IsoGrid/IsoSwitch/HW/HW.kicad_pcb

## KiCad design HW/HW.kicad_pcb (2018-03-01)

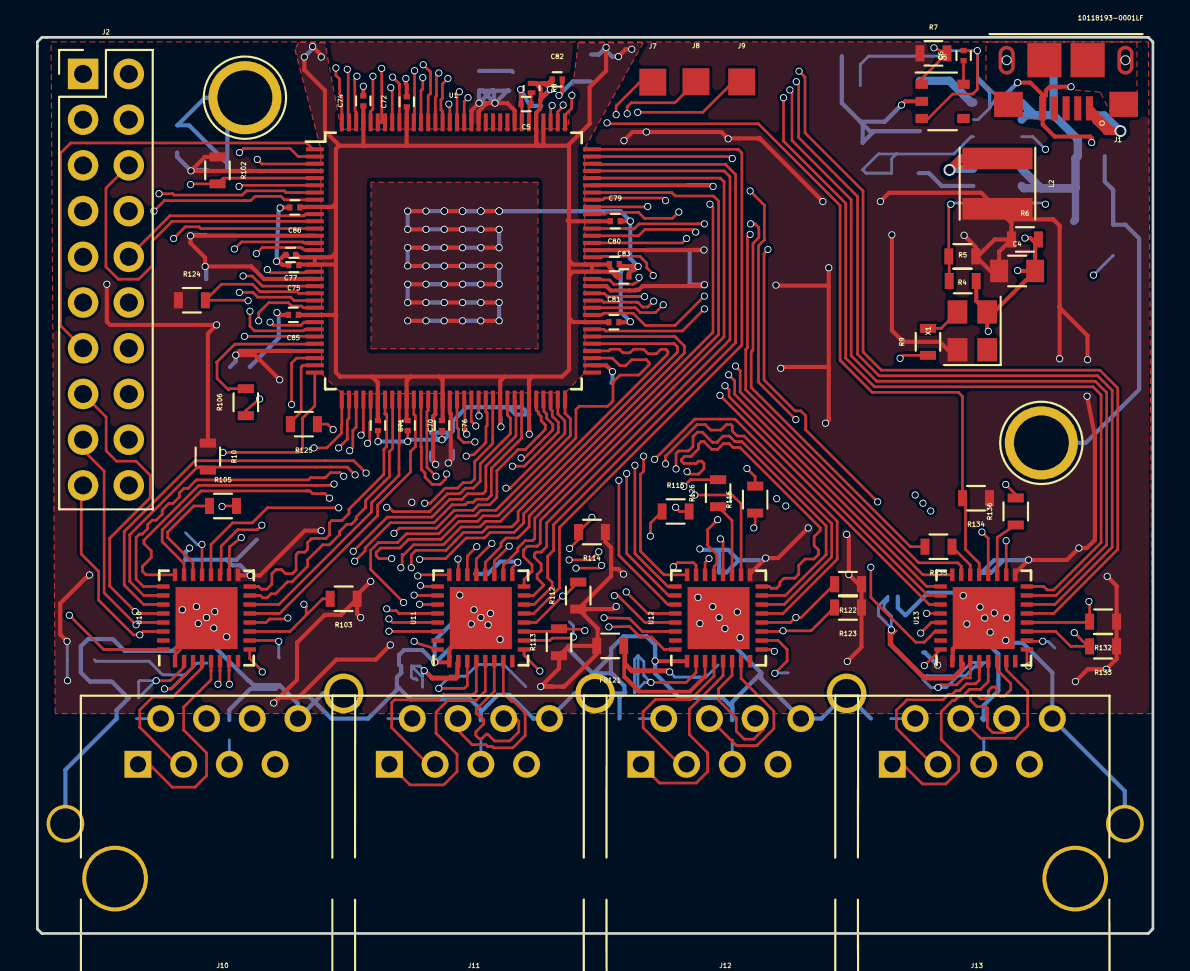
[picture p4: board HW.kicad_pcb from above]

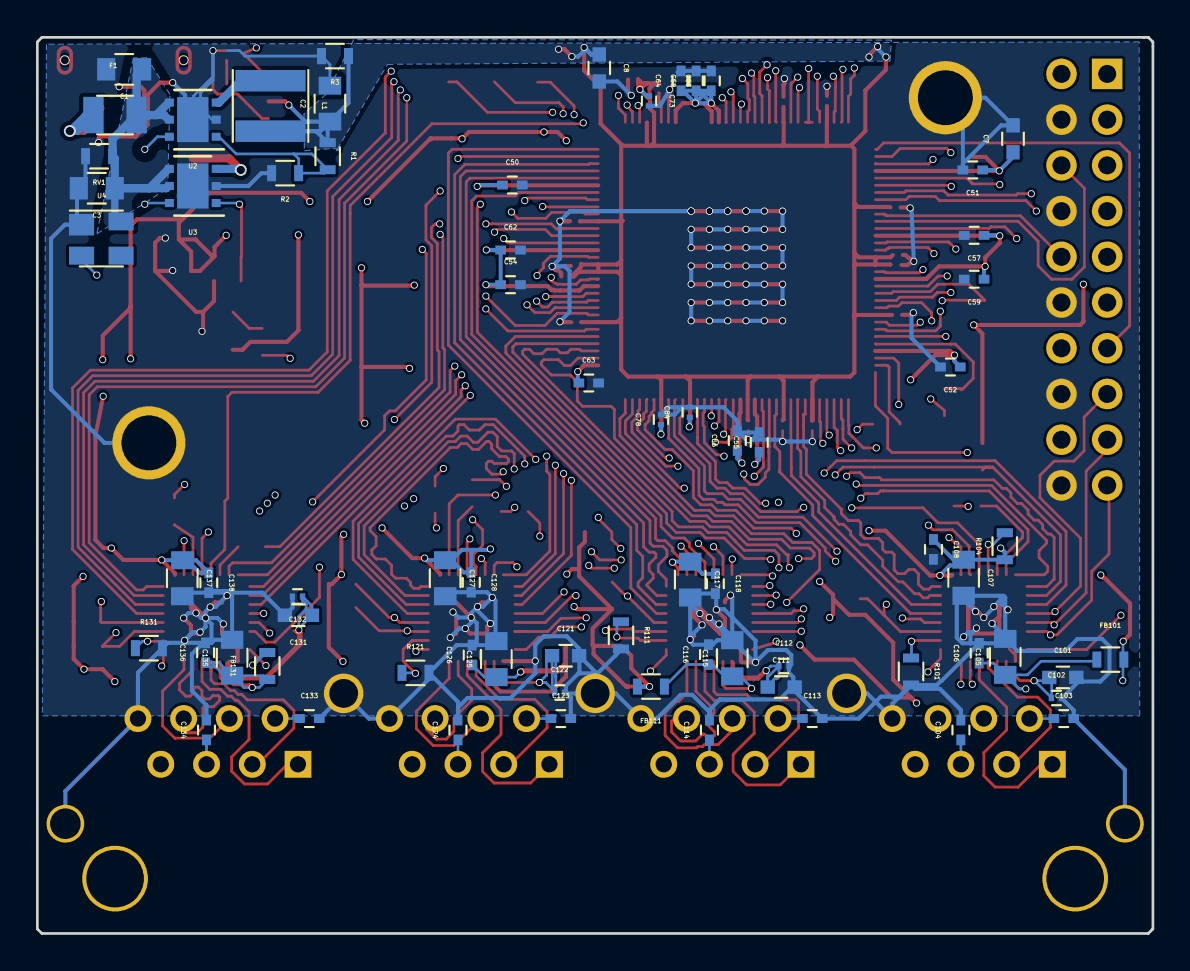
[picture p5: board HW.kicad_pcb from below]

Board: 4 copper layers, 62.0 x 49.8 mm, 133 parts (70 on the bottom side), 147 nets.

Parts:
C1, C3: 4.7uF; C_0805
C2, C4, C105, C107, C115, C117, C125, C127, C135, C137: 22uF; C_0805
C5, C6, C70, C71, C72, C73, C74, C75, C76, C77, C78, C79, C80, C81, C82, C83, C84, C85, C86, C102, C112, C122, C132: 100nF; C_0201
C7, C8, C101, C111, C121, C131: 2.2uF; C_0603
C50, C51, C52, C53, C54, C55, C56, C57, C58, C59, C62, C63, C64, C103, C104, C106, C108, C113, C114, C116, C118, C123, C124, C126, C128, C133, C134, C136, C138: 100nF; C_0402
F1: 1206L110; Fuse_SMD1206_Reflow
FB101, FB111, FB121, FB131: FERRITE BEAD; L_0603
J1: 10118193-0001LF; FCI_10118193-0001LF
J2: 2x10 Vertical Pin; Pin_Header_Straight_2x10_Pitch2.54mm
J7: NWAY_TP; Measurement_Point_Square-SMD-Pad_Small
J8: CRS_TP; Measurement_Point_Square-SMD-Pad_Small
J9: COL_TP; Measurement_Point_Square-SMD-Pad_Small
J10, J11, J12, J13: RJ45_0; RJ45_LINK-PP
L1, L2: 3.3uH; L_Taiyo-Yuden_NR-40xx
Mount2, Mount3: 1pin
R1: 4.7K; R_0603
R2, R4: 18K; R_0603
R3, R103, R104, R113, R114, R123, R124, R133, R134: 1K; R_0603
R5: 5.6K; R_0603
R6: 2.2K; R_0603
R7: 47K; R_0603
R8: 4.7R; R_0201
R9, R105, R106, R115, R116, R125, R126, R135, R136: 33R; R_0603
R10: 3.3K; R_0603
R101, R111, R121, R131: 6.49K; R_0603
R102, R112, R122, R132: 10K; R_0603
RV1: V5.5MLA0603H; R_0603
U1: XL216-512-TQ128_CHIP_VIEW; TQFP-128_14x14mm_Pitch0.4mm
U2, U3: ST1S06; DFN6D_3x3mm
U4: APX811-46UG-7; SOT-143
U5: NCP303LSN10T; TSOP-5_1.65x3.05mm_Pitch0.95mm
U10, U11, U12, U13: KSZ8081MNX; QFN-32-1EP_5x5mm_Pitch0.5mm
X1: DSC6001CI2A-025.0000; Oscillator_SMD_Abracon_ASE-4pin_3.2x2.5mm

Connections:
25M: R9.1, U1.124, U10.9, U11.9, U12.9, U13.9
+1V0: C2.1, C8.1, C70.1, C71.1, C72.1, C73.1, C74.1, C75.1, C76.1, C77.1, C78.1, C79.1, C80.1, C81.1, C82.1, C83.1, C84.1, C85.1, C86.1, L1.2, R1.1, R3.1, R8.1, U1.9, U1.16, U1.17, U1.24, U1.38, U1.42, U1.47, U1.55, U1.59, U1.72, U1.79, U1.80, U1.86, U1.100, U1.101, U1.119, U1.125, U5.2
+3V3: C4.1, C7.1, C50.1, C51.1, C52.1, C53.1, C54.1, C55.1, C56.1, C57.1, C58.1, C59.1, C62.1, C63.1, C64.1, C107.1, C108.1, C117.1, C118.1, C127.1, C128.1, C137.1, C138.1, FB101.2, FB111.2, FB121.2, FB131.2, L2.2, R4.1, R6.1, R7.1, R10.1, R102.1, R103.1, R104.1, R112.1, R113.1, R114.1, R122.1, R123.1, R124.1, R132.1, R133.1, R134.1, U1.4, U1.13, U1.19, U1.29, U1.46, U1.48, U1.66, U1.77, U1.82, U1.91, U1.104, U1.109, U1.110, U10.17, U11.17, U12.17, U13.17, X1.4
+5V: C1.1, C3.1, F1.2, RV1.1, U2.4, U2.5, U3.4, U3.5, U4.4
/PG_5V: U2.6, U3.6, U4.2
/Tile0/EthernetPort0/INT: R104.2, U1.6, U10.21
/Tile0/EthernetPort0/MDC: R102.2, U1.5, U10.12
/Tile0/EthernetPort0/MDIO: R103.2, U1.3, U10.11
/Tile0/EthernetPort0/RST_N: U1.2, U10.32
/Tile0/EthernetPort0/RXC: R106.2, U1.28
/Tile0/EthernetPort0/RXD0: U1.39, U10.16
/Tile0/EthernetPort0/RXD1: U1.40, U10.15
/Tile0/EthernetPort0/RXD2: U1.41, U10.14
/Tile0/EthernetPort0/RXD3: U1.43, U10.13
/Tile0/EthernetPort0/RXDV: U1.27, U10.18
/Tile0/EthernetPort0/RXERR: U1.56, U10.20
/Tile0/EthernetPort0/TXC: R105.2, U1.32
/Tile0/EthernetPort0/TXD0: U1.34, U10.24
/Tile0/EthernetPort0/TXD1: U1.35, U10.25
/Tile0/EthernetPort0/TXD2: R10.2, U1.36, U10.26
/Tile0/EthernetPort0/TXD3: U1.37, U10.27
/Tile0/EthernetPort0/TXEN: U1.33, U10.23
/Tile0/EthernetPort1/COL: J9.1, U1.97, U11.28
/Tile0/EthernetPort1/CRS: J8.1, U1.98, U11.29
/Tile0/EthernetPort1/INT: R114.2, U1.63, U11.21
/Tile0/EthernetPort1/MDC: R112.2, U1.87, U11.12
/Tile0/EthernetPort1/MDIO: R113.2, U1.88, U11.11
/Tile0/EthernetPort1/NWAYEN: J7.1, U1.99, U11.30
/Tile0/EthernetPort1/RST_N: U1.64, U11.32
/Tile0/EthernetPort1/RXC: R116.2, U1.89
/Tile0/EthernetPort1/RXD0: U1.92, U11.16
/Tile0/EthernetPort1/RXD1: U1.93, U11.15
/Tile0/EthernetPort1/RXD2: U1.94, U11.14
/Tile0/EthernetPort1/RXD3: U1.96, U11.13
/Tile0/EthernetPort1/RXDV: U1.90, U11.18
/Tile0/EthernetPort1/RXERR: U1.95, U11.20
/Tile0/EthernetPort1/TXC: R115.2, U1.62
/Tile0/EthernetPort1/TXD0: U1.67, U11.24
/Tile0/EthernetPort1/TXD1: U1.68, U11.25
/Tile0/EthernetPort1/TXD2: U1.69, U11.26
/Tile0/EthernetPort1/TXD3: U1.70, U11.27
/Tile0/EthernetPort1/TXEN: U1.61, U11.23
/Tile1/EthernetPort2/COL: U1.25, U12.28
/Tile1/EthernetPort2/CRS: U1.23, U12.29
/Tile1/EthernetPort2/INT: R124.2, U1.21, U12.21
/Tile1/EthernetPort2/MDC: R122.2, U1.53, U12.12
/Tile1/EthernetPort2/MDIO: R123.2, U1.54, U12.11
/Tile1/EthernetPort2/NWAYEN: U1.22, U12.30
/Tile1/EthernetPort2/RST_N: U1.20, U12.32
/Tile1/EthernetPort2/RXC: R126.2, U1.44
/Tile1/EthernetPort2/RXD0: U1.49, U12.16
/Tile1/EthernetPort2/RXD1: U1.50, U12.15
/Tile1/EthernetPort2/RXD2: U1.51, U12.14
/Tile1/EthernetPort2/RXD3: U1.52, U12.13
/Tile1/EthernetPort2/RXDV: U1.45, U12.18
/Tile1/EthernetPort2/RXERR: U1.26, U12.20
/Tile1/EthernetPort2/TXC: R125.2, U1.31
/Tile1/EthernetPort2/TXD0: U1.111, U12.24
/Tile1/EthernetPort2/TXD1: U1.112, U12.25
/Tile1/EthernetPort2/TXD2: U1.117, U12.26
/Tile1/EthernetPort2/TXD3: U1.118, U12.27
/Tile1/EthernetPort2/TXEN: U1.30, U12.23
/Tile1/EthernetPort3/COL: U1.73, U13.28
/Tile1/EthernetPort3/CRS: U1.81, U13.29
/Tile1/EthernetPort3/INT: R134.2, U1.12, U13.21
/Tile1/EthernetPort3/MDC: R132.2, U1.14, U13.12
/Tile1/EthernetPort3/MDIO: R133.2, U1.15, U13.11
/Tile1/EthernetPort3/NWAYEN: U1.83, U13.30
/Tile1/EthernetPort3/RST_N: U1.18, U13.32
/Tile1/EthernetPort3/RXC: R136.2, U1.120
/Tile1/EthernetPort3/RXD0: U1.113, U13.16
/Tile1/EthernetPort3/RXD1: U1.114, U13.15
/Tile1/EthernetPort3/RXD2: U1.115, U13.14
/Tile1/EthernetPort3/RXD3: U1.116, U13.13
/Tile1/EthernetPort3/RXDV: U1.121, U13.18
/Tile1/EthernetPort3/RXERR: U1.71, U13.20
/Tile1/EthernetPort3/TXC: R135.2, U1.85
/Tile1/EthernetPort3/TXD0: U1.74, U13.24
/Tile1/EthernetPort3/TXD1: U1.75, U13.25
/Tile1/EthernetPort3/TXD2: U1.76, U13.26
/Tile1/EthernetPort3/TXD3: U1.78, U13.27
/Tile1/EthernetPort3/TXEN: U1.84, U13.23
COL0: J2.15, U1.57, U10.28
CRS0: J2.17, U1.58, U10.29
GND: C1.2, C2.2, C3.2, C4.2, C5.2, C6.2, C7.2, C8.2, C50.2, C51.2, C52.2, C53.2, C54.2, C55.2, C56.2, C57.2, C58.2, C59.2, C62.2, C63.2, C64.2, C70.2, C71.2, C72.2, C73.2, C74.2, C75.2, C76.2, C77.2, C78.2, C79.2, C80.2, C81.2, C82.2, C83.2, C84.2, C85.2, C86.2, C101.2, C102.2, C103.2, C104.2, C105.2, C106.2, C107.2, C108.2, C111.2, C112.2, C113.2, C114.2, C115.2, C116.2, C117.2, C118.2, C121.2, C122.2, C123.2, C124.2, C125.2, C126.2, C127.2, C128.2, C131.2, C132.2, C133.2, C134.2, C135.2, C136.2, C137.2, C138.2, J1.5, J2.4, J2.8, J2.12, J2.16, J2.20, J10.8, J10.9, J10.10, J11.8, J11.10, J12.8, J12.10, J13.8, J13.11, Mount2.1, Mount3.1, R2.2, R3.2, R5.2, R6.2, R101.2, R111.2, R121.2, R131.2, RV1.2, U1.103, U2.2, U2.7, U3.2, U3.7, U4.1, U5.3, U10.1, U10.33, U11.1, U11.33, U12.1, U12.33, U13.1, U13.33, X1.2
NWAYEN0: J2.19, U1.60, U10.30
unnamed: C5.1, R8.2, U1.102
unnamed: C6.1, U5.6
unnamed: C101.1, C102.1, U10.2
unnamed: C103.1, J10.2
unnamed: C104.1, J10.5
unnamed: C105.1, C106.1, FB101.1, U10.3
unnamed: C111.1, C112.1, U11.2
unnamed: C113.1, J11.2
unnamed: C114.1, J11.5
unnamed: C115.1, C116.1, FB111.1, U11.3
unnamed: C121.1, C122.1, U12.2
unnamed: C123.1, J12.2
unnamed: C124.1, J12.5
unnamed: C125.1, C126.1, FB121.1, U12.3
unnamed: C131.1, C132.1, U13.2
unnamed: C133.1, J13.2
unnamed: C134.1, J13.5
unnamed: C135.1, C136.1, FB131.1, U13.3
unnamed: F1.1, J1.1
unnamed: J2.5, U1.128
unnamed: J2.6, U1.11
unnamed: J2.7, U1.126
unnamed: J2.9, U1.127
unnamed: J2.10, U1.10
unnamed: J2.13, U1.1
unnamed: J2.14, U1.8
unnamed: J2.18, U1.7
unnamed: J10.1, U10.5
unnamed: J10.3, U10.4
unnamed: J10.4, U10.7
unnamed: J10.6, U10.6
unnamed: J11.1, U11.5
unnamed: J11.3, U11.4
unnamed: J11.4, U11.7
unnamed: J11.6, U11.6
unnamed: J12.1, U12.5
unnamed: J12.3, U12.4
unnamed: J12.4, U12.7
unnamed: J12.6, U12.6
unnamed: J13.1, U13.5
unnamed: J13.3, U13.4
unnamed: J13.4, U13.7
unnamed: J13.6, U13.6
unnamed: L1.1, U2.3
unnamed: L2.1, U3.3
unnamed: R1.2, R2.1, U2.1
unnamed: R4.2, R5.1, U3.1
unnamed: R7.2, U1.122, U1.123, U5.1
unnamed: R9.2, X1.3
unnamed: R101.1, U10.10
unnamed: R105.1, U10.22
unnamed: R106.1, U10.19
unnamed: R111.1, U11.10
unnamed: R115.1, U11.22
unnamed: R116.1, U11.19
unnamed: R121.1, U12.10
unnamed: R125.1, U12.22
unnamed: R126.1, U12.19
unnamed: R131.1, U13.10
unnamed: R135.1, U13.22
unnamed: R136.1, U13.19
