IsoGrid/IsoSwitch/(commit log)

2018-01-06 Releasing IsoSwitch.201801
    [EthernetPortX.sch, HW.csv, HW.kicad_pcb, HW.sch, HW.xlsx, Port0.sch, Tile0.sch, Tile1.sch]
2018-03-01 Releasing IsoSwitch.201802
    [EthernetPortX.sch, HW.kicad_pcb, HW.sch, Tile0.sch, Tile1.sch]
